bhuvan11000/ultrasonic-occupancy-counter/hardware/circuit-wiring.png

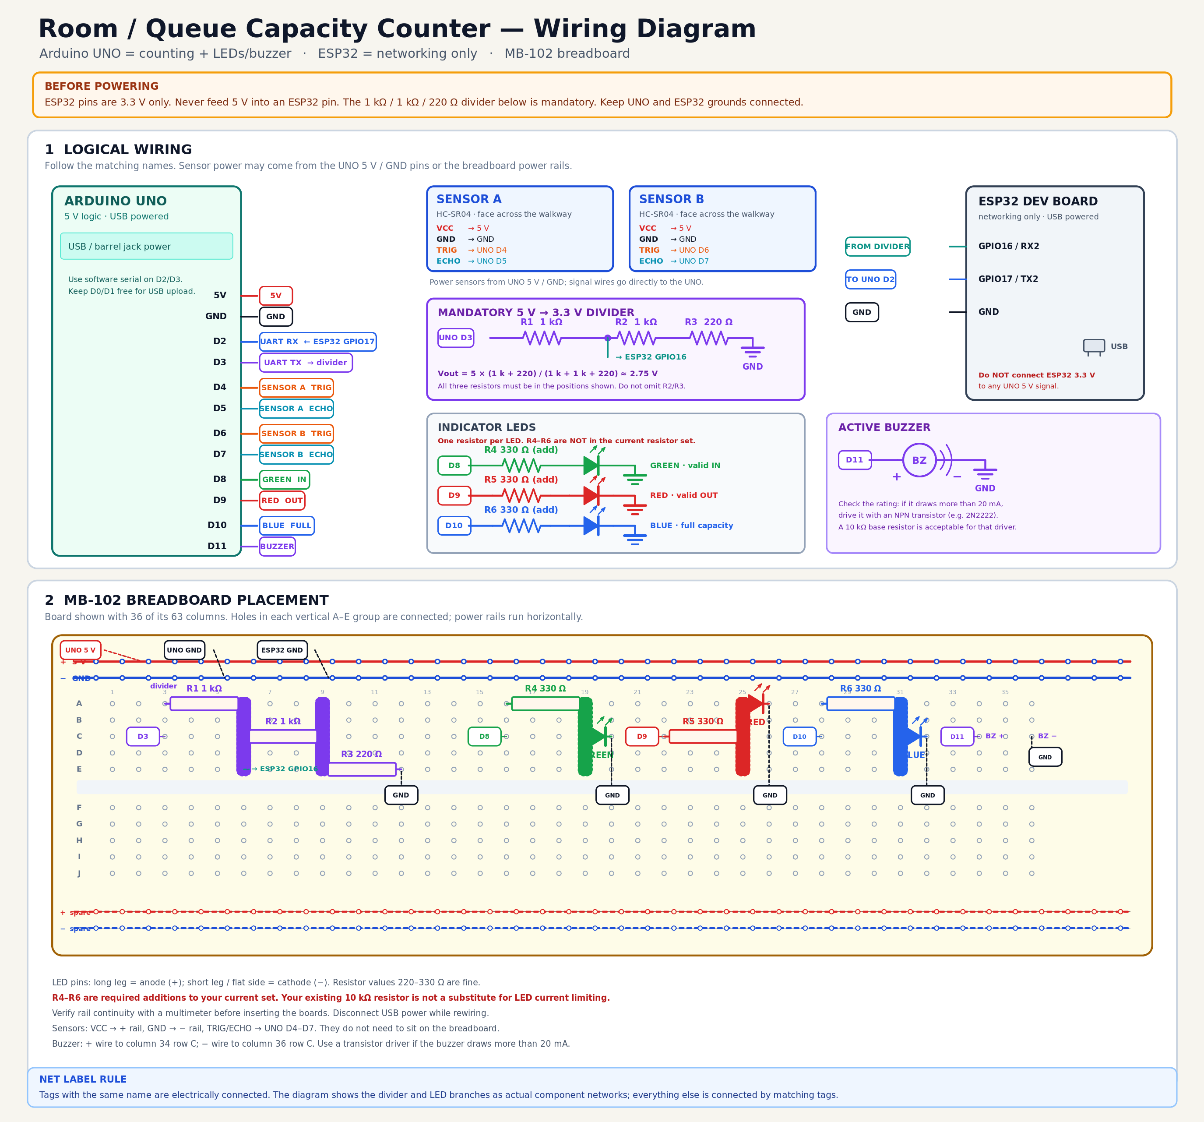
hardware/circuit-wiring.png
