bhuvan11000/ultrasonic-occupancy-counter/code/esp32/local_dashboard/secrets.example.h

#pragma once

// Copy this file to secrets.h and fill in your local Wi-Fi details.
// If the connection fails, the ESP32 starts its own access point instead.

#define WIFI_SSID "YOUR_WIFI_NAME"
#define WIFI_PASSWORD "YOUR_WIFI_PASSWORD"
