bhuvan11000/ultrasonic-occupancy-counter/(commit log)

2026-11-05 add hardware wiring and test scripts
2026-11-06 Add buzzer and sensor wiring diagnostics
    [01b_buzzer_test.ino, 01c_buzzer_diagnostic.ino, 04_sensor_pin_loopback.ino]
2026-11-06 Add ESP32 local dashboard server and project docs
2026-11-06 Remove obsolete wiring diagrams from README
    Removed outdated wiring diagrams from the README.
